onnoeberhard/bachelorprojekt/Screenshot 2020-01-07 at 12.10.59.png

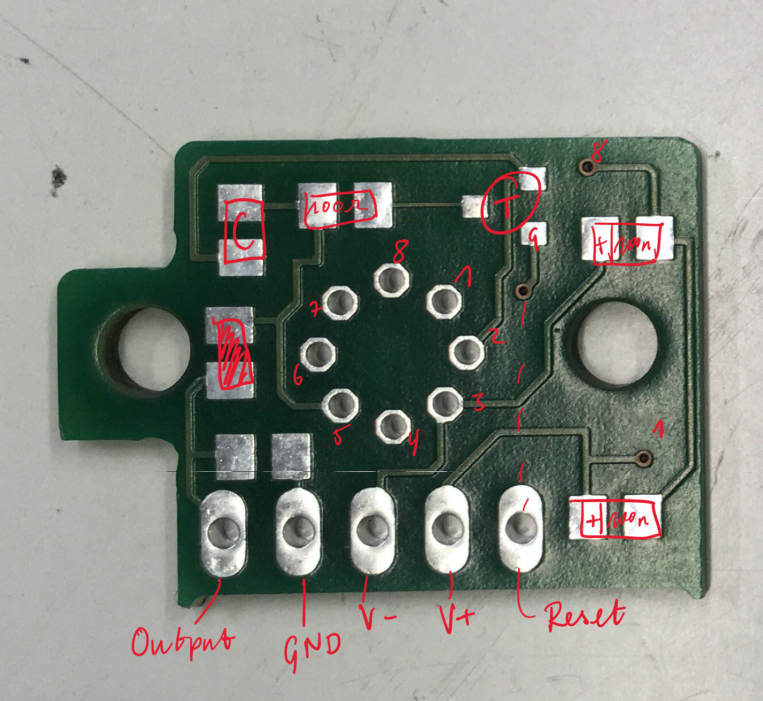
Screenshot 2020-01-07 at 12.10.59.png
