onnoeberhard/bachelorprojekt/Screenshot 2020-01-07 at 12.11.06.png

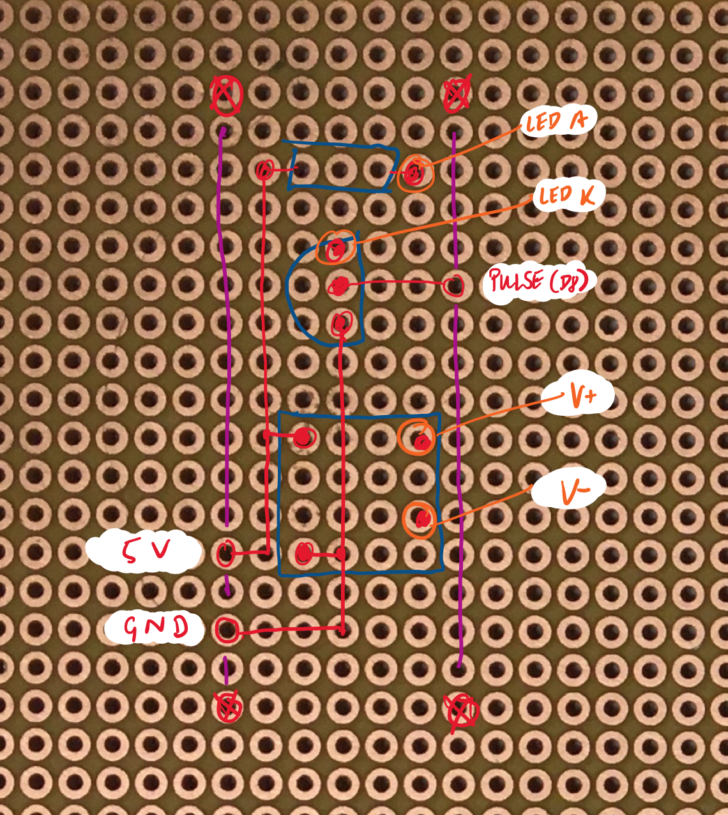
Screenshot 2020-01-07 at 12.11.06.png
