onnoeberhard/bachelorprojekt/Präsentation Onno.pptx

## Elektronik I

## Elektronik II

- Stromversorgung und Steuerung durch Arduino
  - Messwert: “Ouptut”
  - Kondensator entladen: “Reset”
  - LED steuern: “Pulse”
- Zu finden:
  - Widerstand in der LED-Schaltung:
    - Berechnet: R=29,25 Ω
    - Entscheidung: R=33 Ω
  - Integrationszeit: T=100 ms

## Slide 3

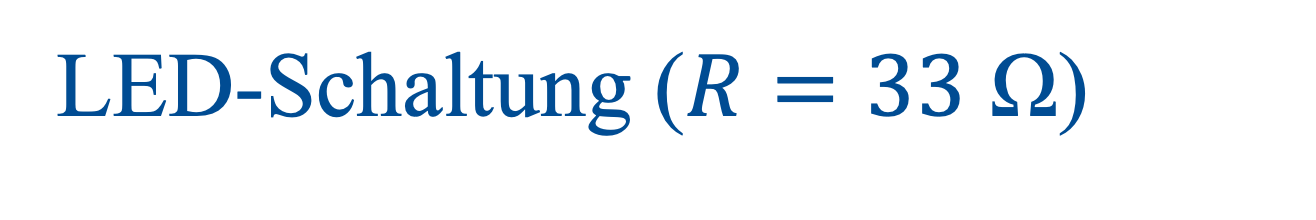
[picture p54: figure]

## Integrationszeit


## Referenzmessung I

- Berechnung der Dämpfung [dB] aus den Messwerten [0..1023]


## Referenzmessung II

- Abziehen des Hintergrundstörwerts

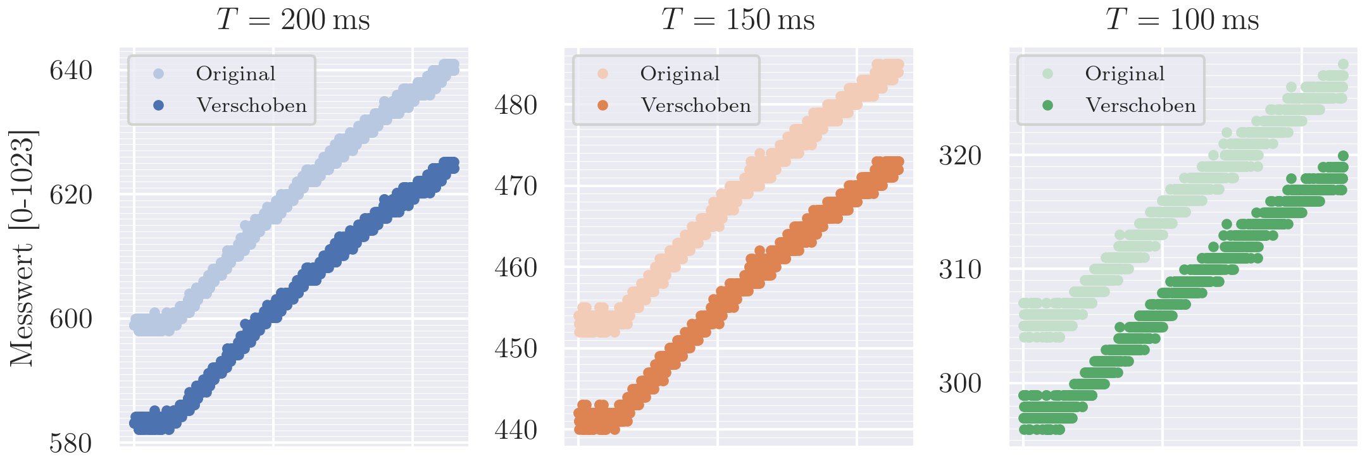
[picture p55: figure]

## Referenzmessung III

- Gättung der Kurve (Gewichteter Mittelwert)


## Referenzmessung IV


## Referenzmessung V

- Umrechnung mit der Formel:
y(t;t_0 , k, b)=kx(t−t_0 )+b
- Gefundene Parameter:
- Für T=100 ms: k=0,073 dB

## Endprodukt

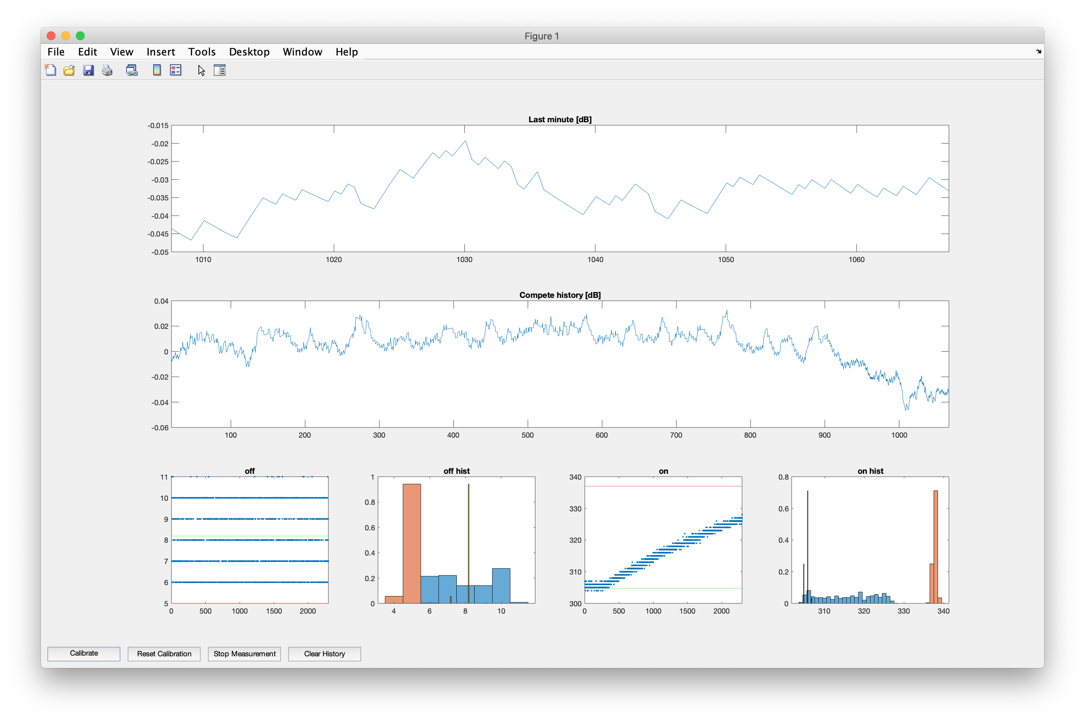
[picture p56: figure]
