onnoeberhard/bachelorprojekt/akf_schaltung.png

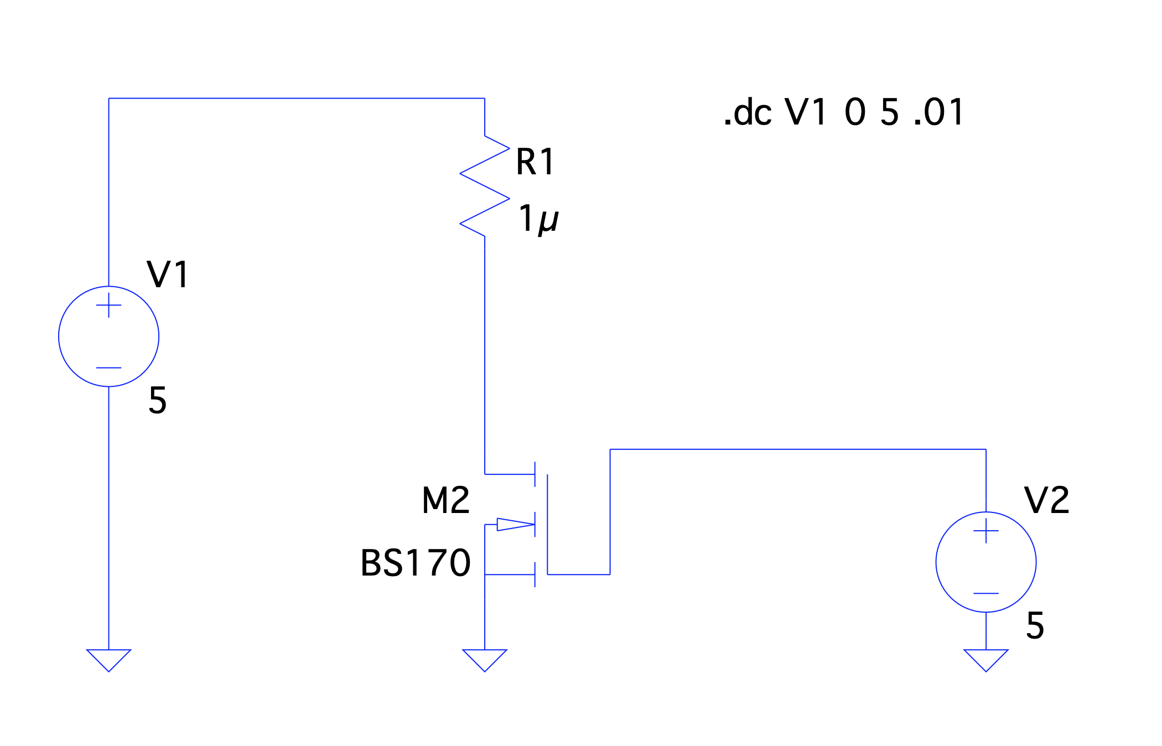
akf_schaltung.png
