onnoeberhard/bachelorprojekt/allspice.png

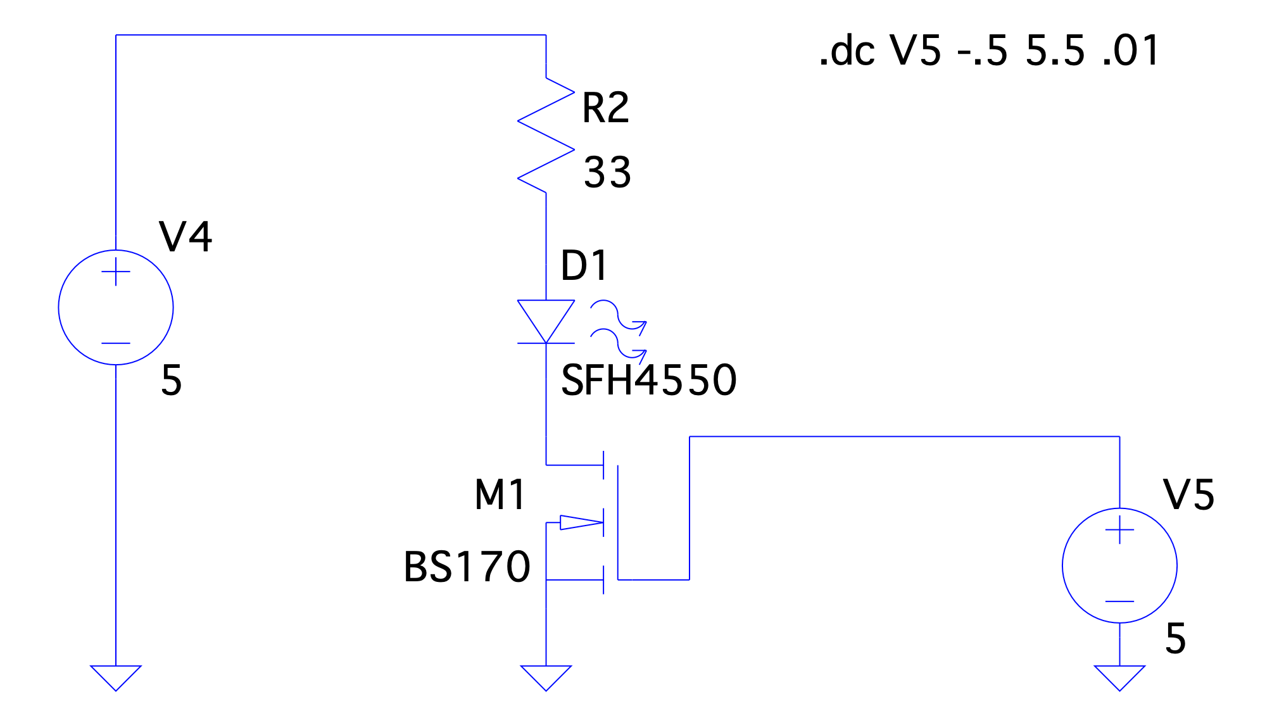
allspice.png
