onnoeberhard/bachelorprojekt/erste Messung.PNG

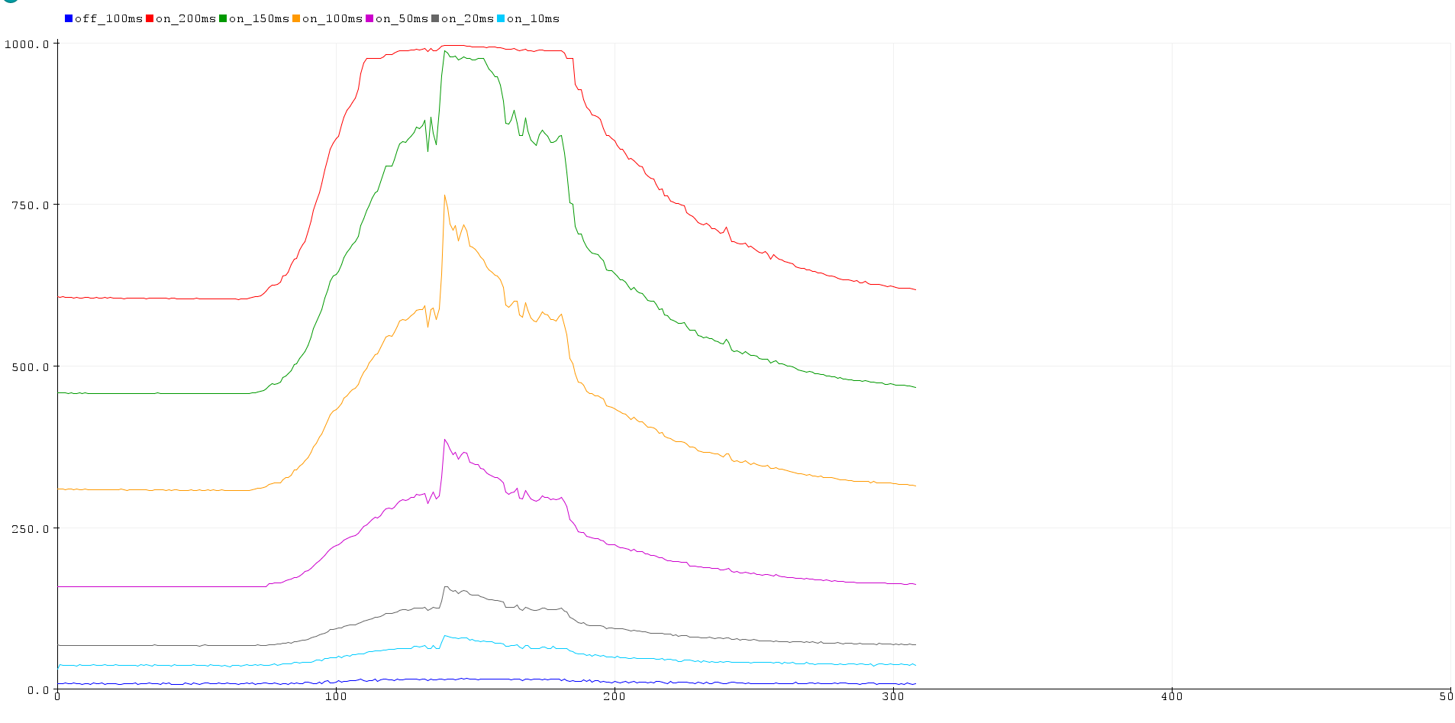
erste Messung.PNG
