onnoeberhard/bachelorprojekt/kalt.png

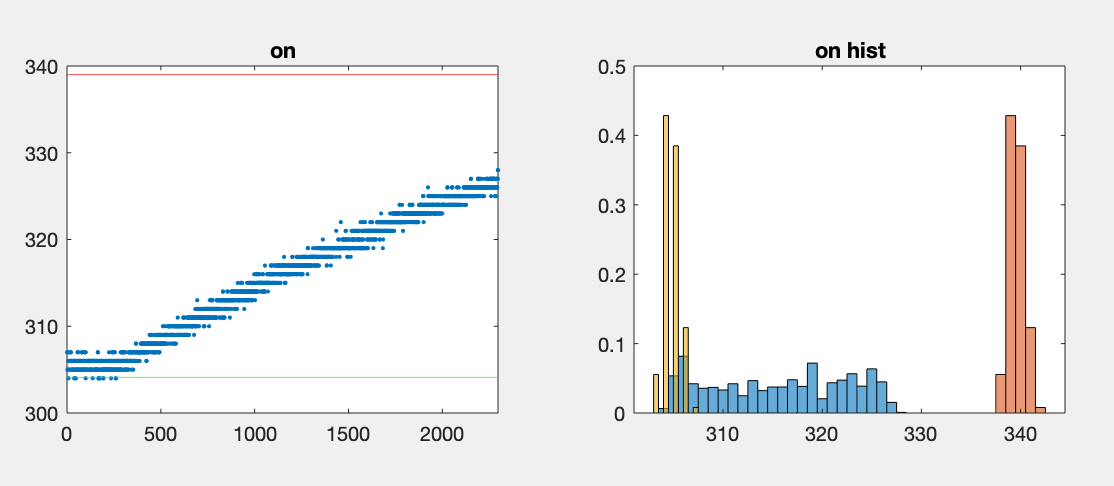
kalt.png
