onnoeberhard/bachelorprojekt/kalt_.png

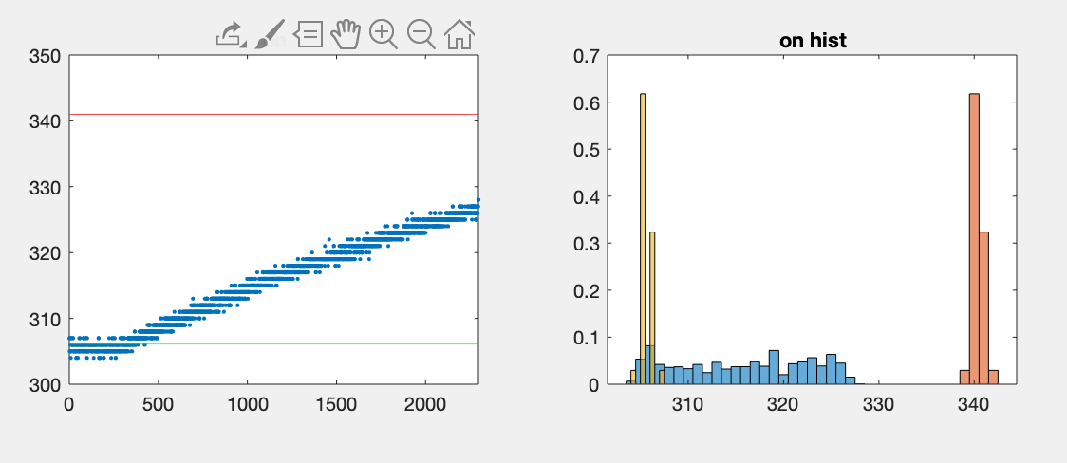
kalt_.png
