onnoeberhard/bachelorprojekt/ledspice.png

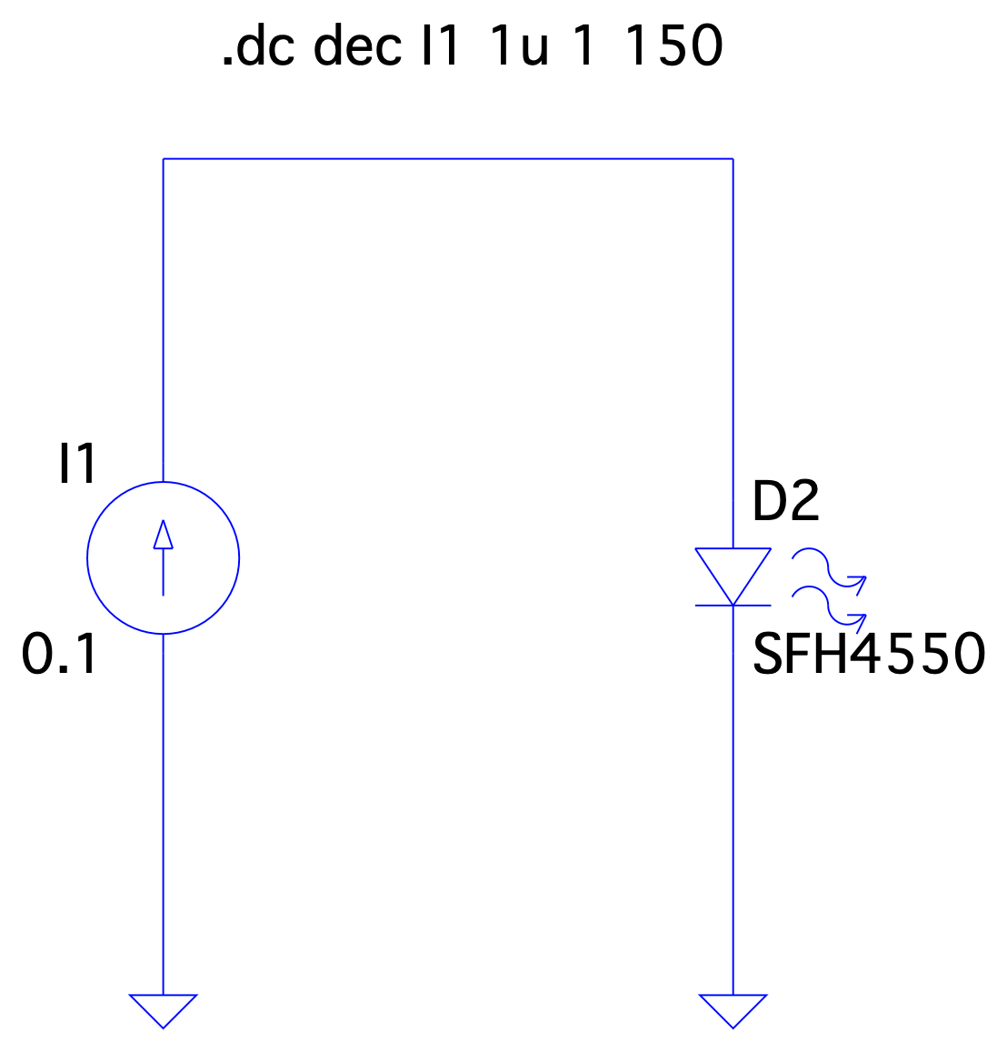
ledspice.png
