onnoeberhard/bachelorprojekt/schaltung.png

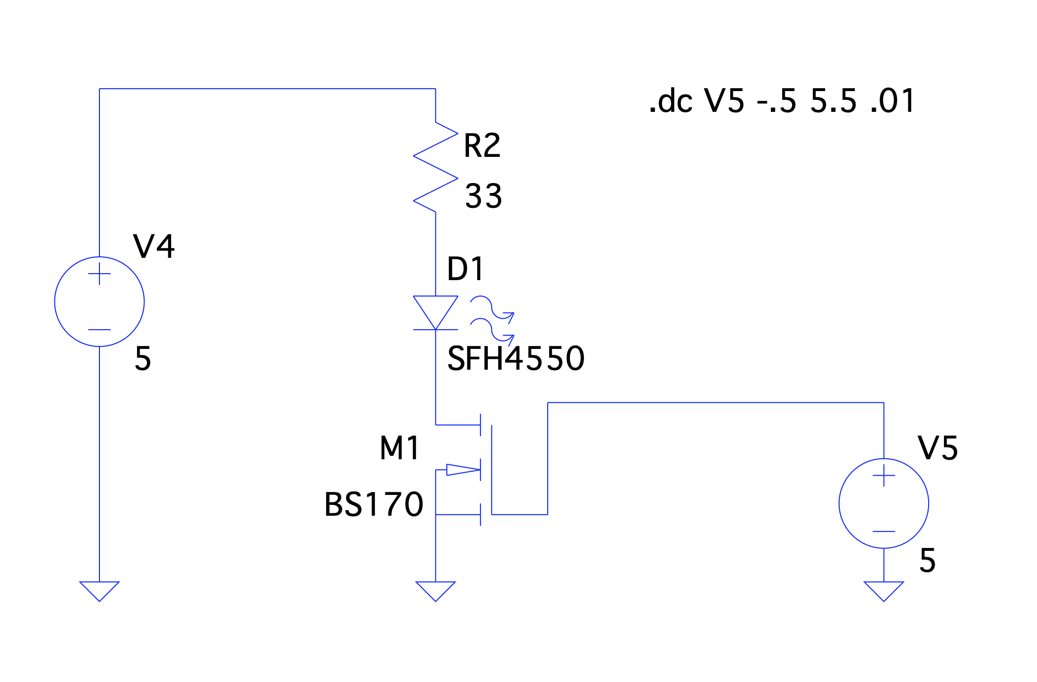
schaltung.png
