onnoeberhard/bachelorprojekt/Screenshot 2019-11-19 at 14.21.47.png

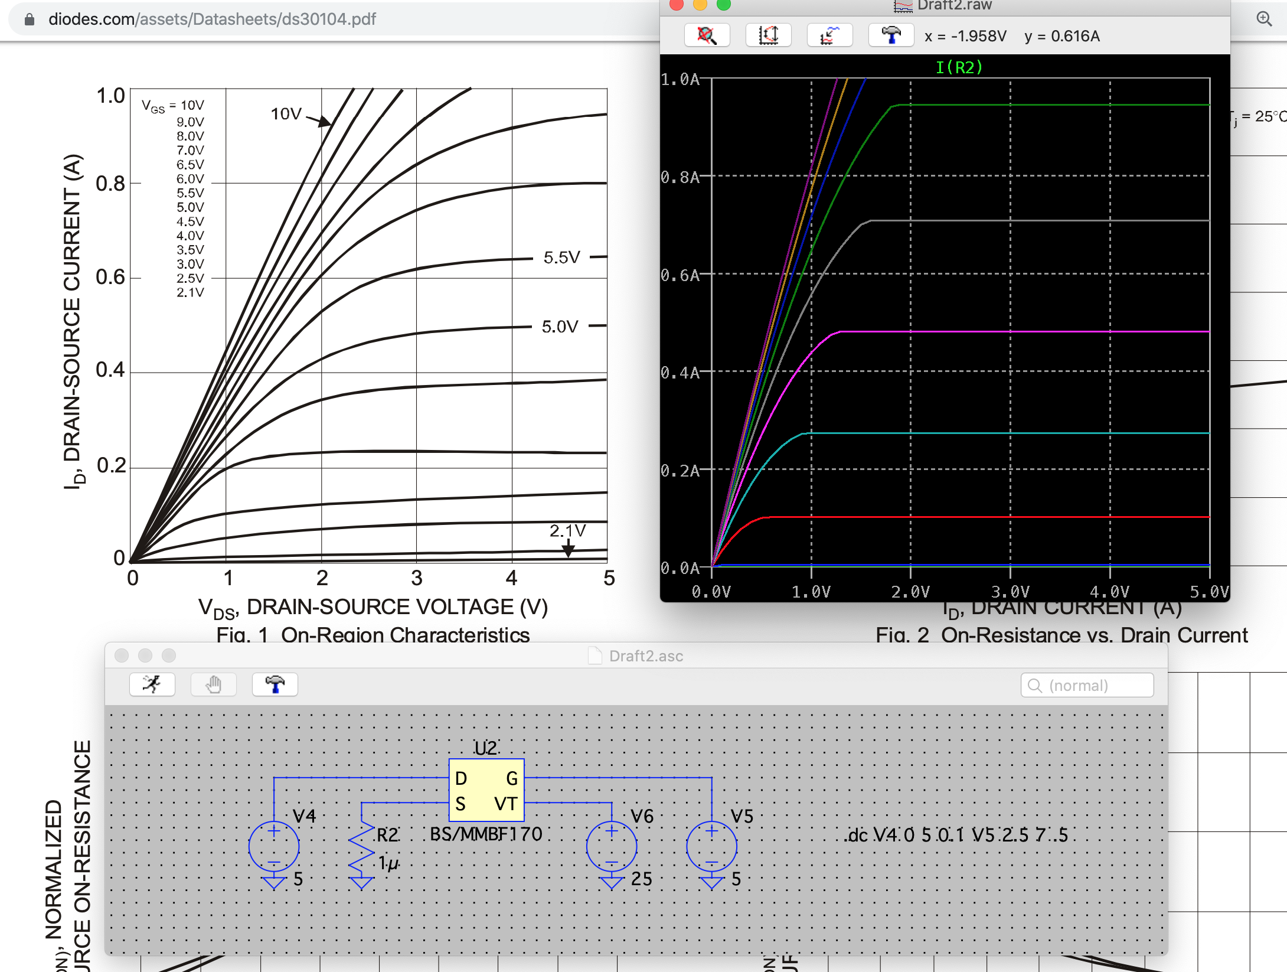
Screenshot 2019-11-19 at 14.21.47.png
