onnoeberhard/bachelorprojekt/Screenshot 2019-11-19 at 14.25.37.png

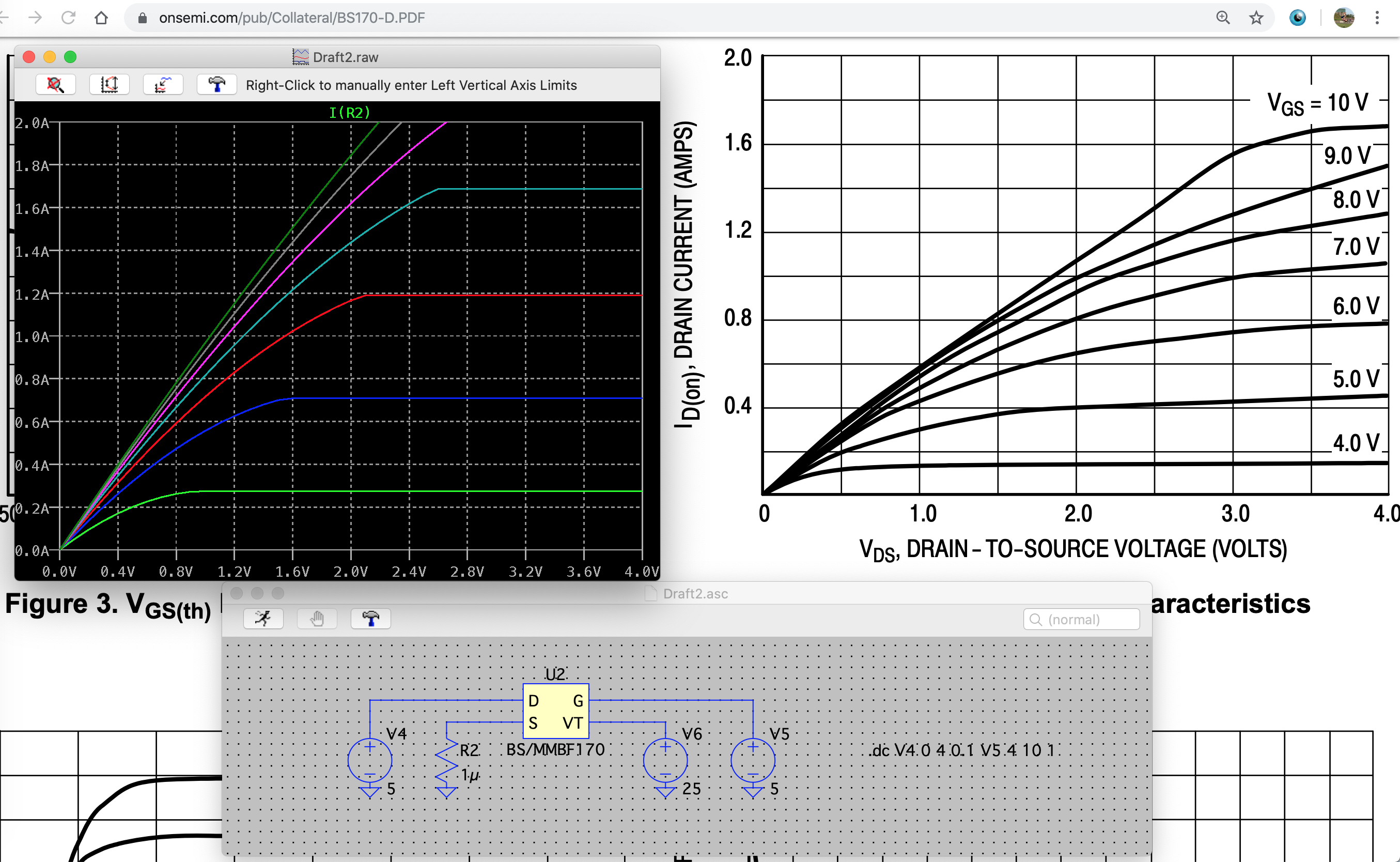
Screenshot 2019-11-19 at 14.25.37.png
