onnoeberhard/bachelorprojekt/Screenshot 2019-11-26 at 10.58.21.png

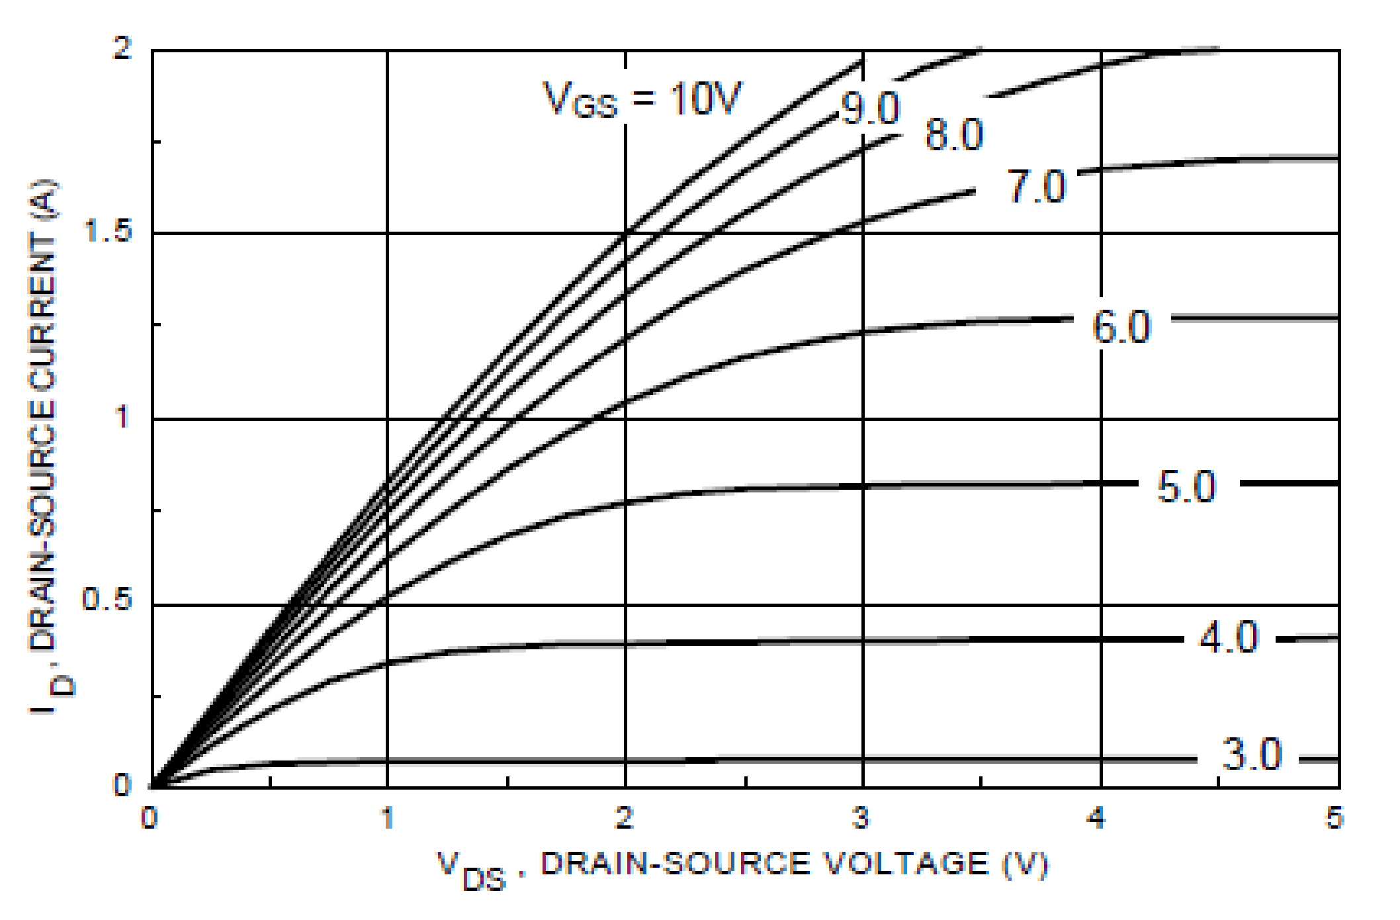
Screenshot 2019-11-26 at 10.58.21.png
