onnoeberhard/bachelorprojekt/Screenshot 2019-11-26 at 14.03.40.png

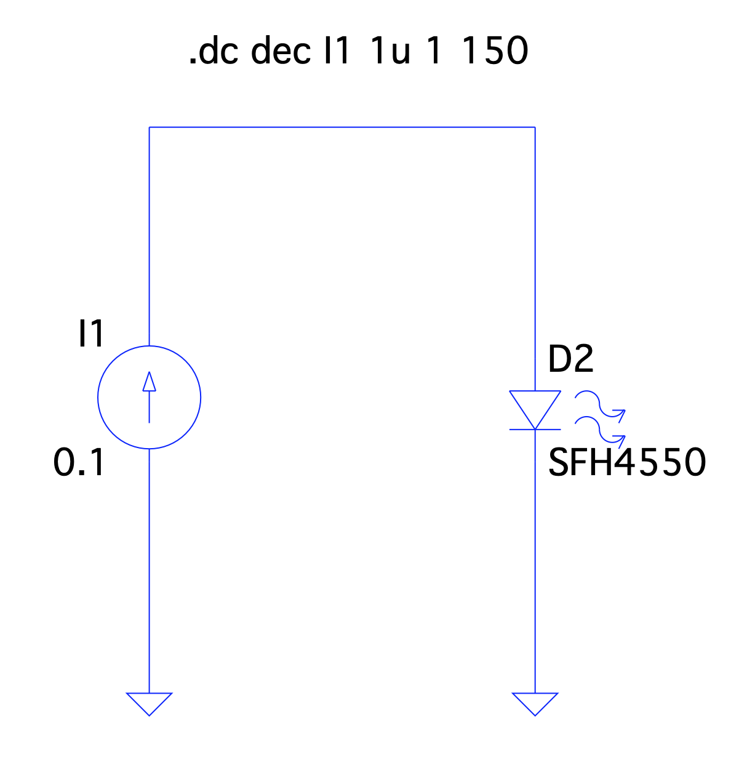
Screenshot 2019-11-26 at 14.03.40.png
