onnoeberhard/bachelorprojekt/Screenshot 2020-03-29 at 17.16.46.png

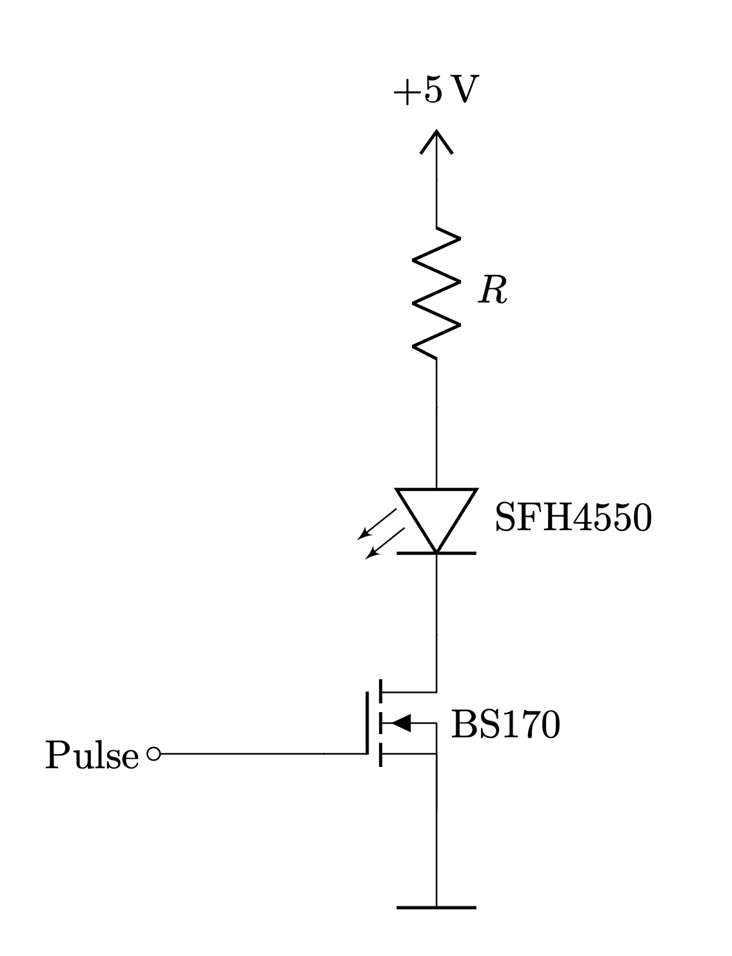
Screenshot 2020-03-29 at 17.16.46.png
