onnoeberhard/bachelorprojekt/Screenshot 2020-03-30 at 19.29.19.png

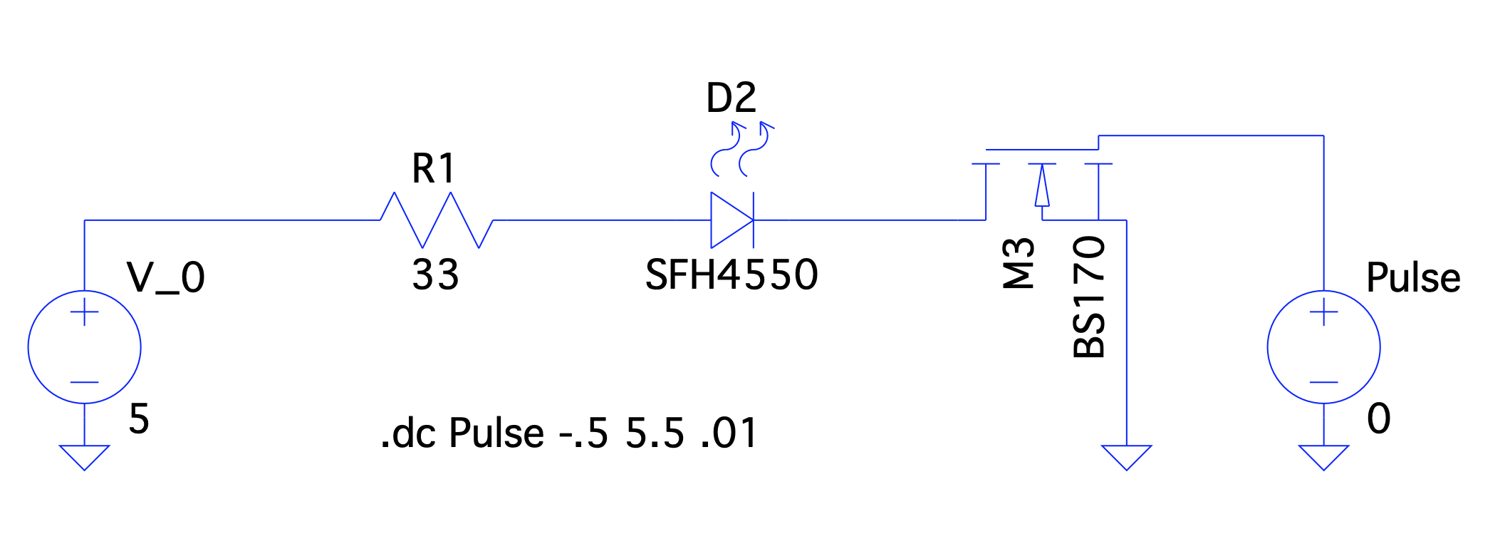
Screenshot 2020-03-30 at 19.29.19.png
