onnoeberhard/bachelorprojekt/Screenshot 2020-04-09 at 15.24.42.png

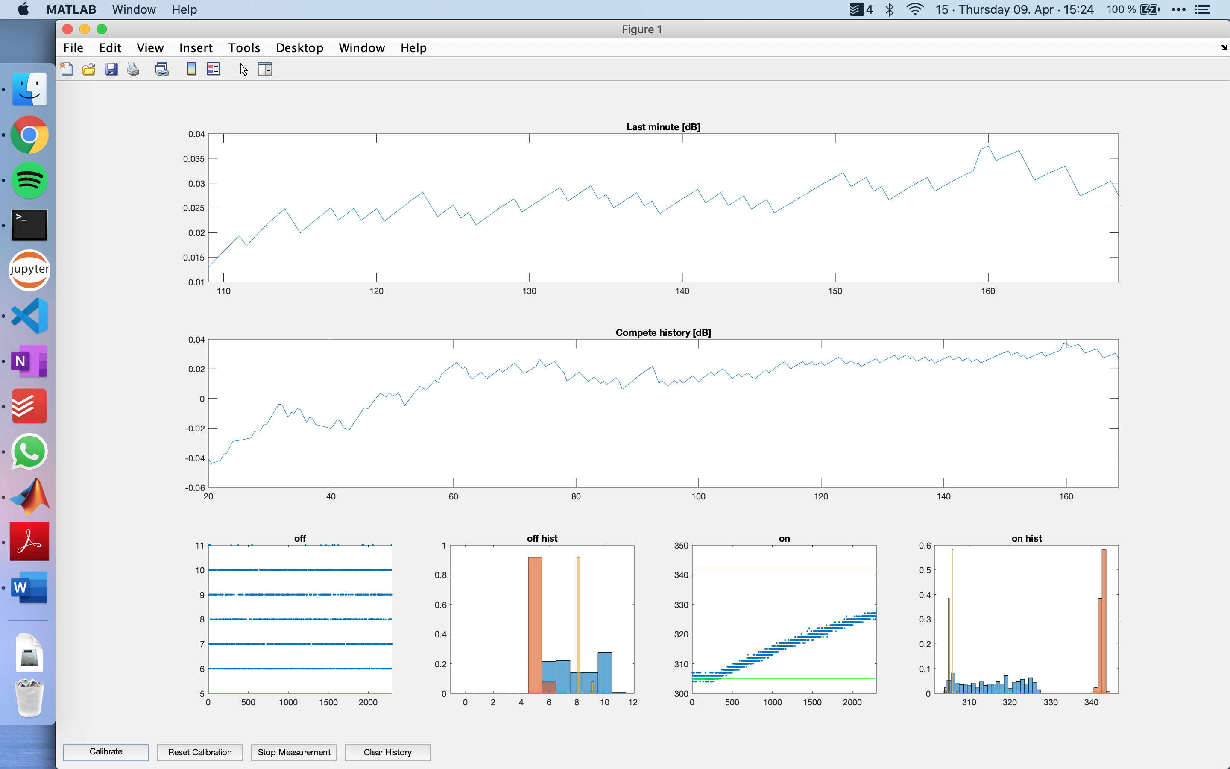
Screenshot 2020-04-09 at 15.24.42.png
