onnoeberhard/bachelorprojekt/Screenshot 2020-04-09 at 15.40.19.png

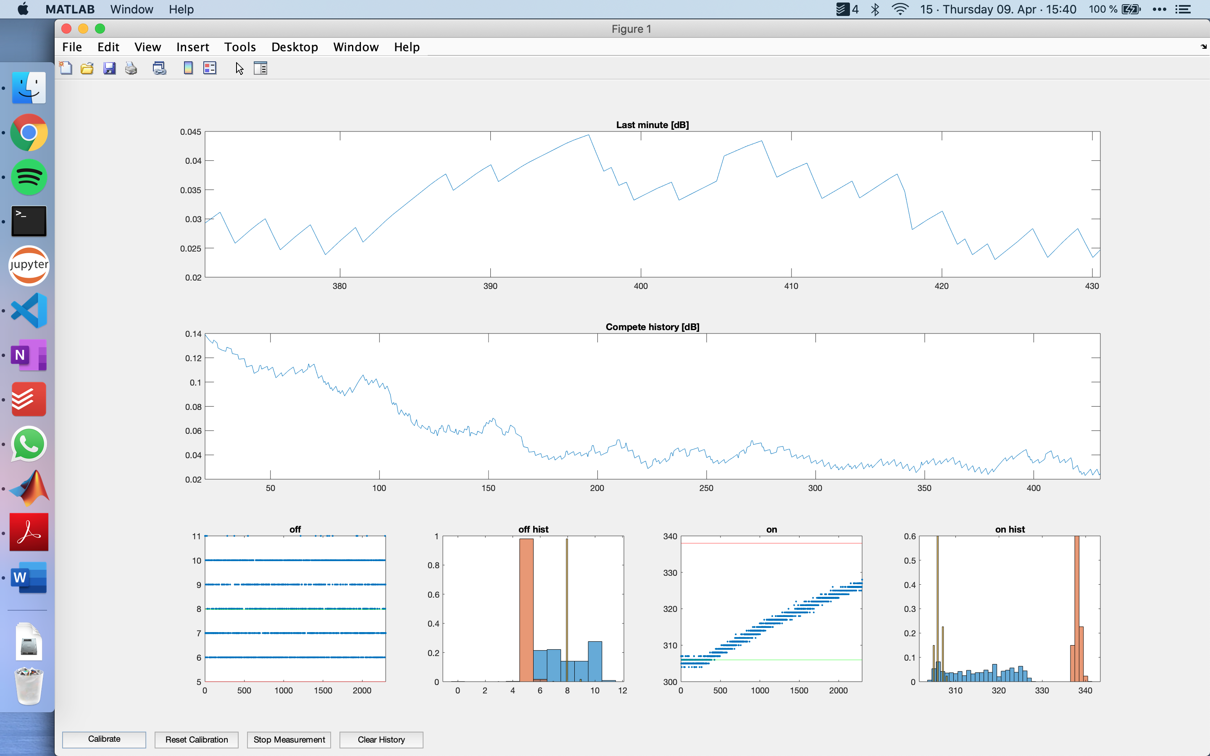
Screenshot 2020-04-09 at 15.40.19.png
