onnoeberhard/bachelorprojekt/Screenshot 2020-04-09 at 15.43.36.png

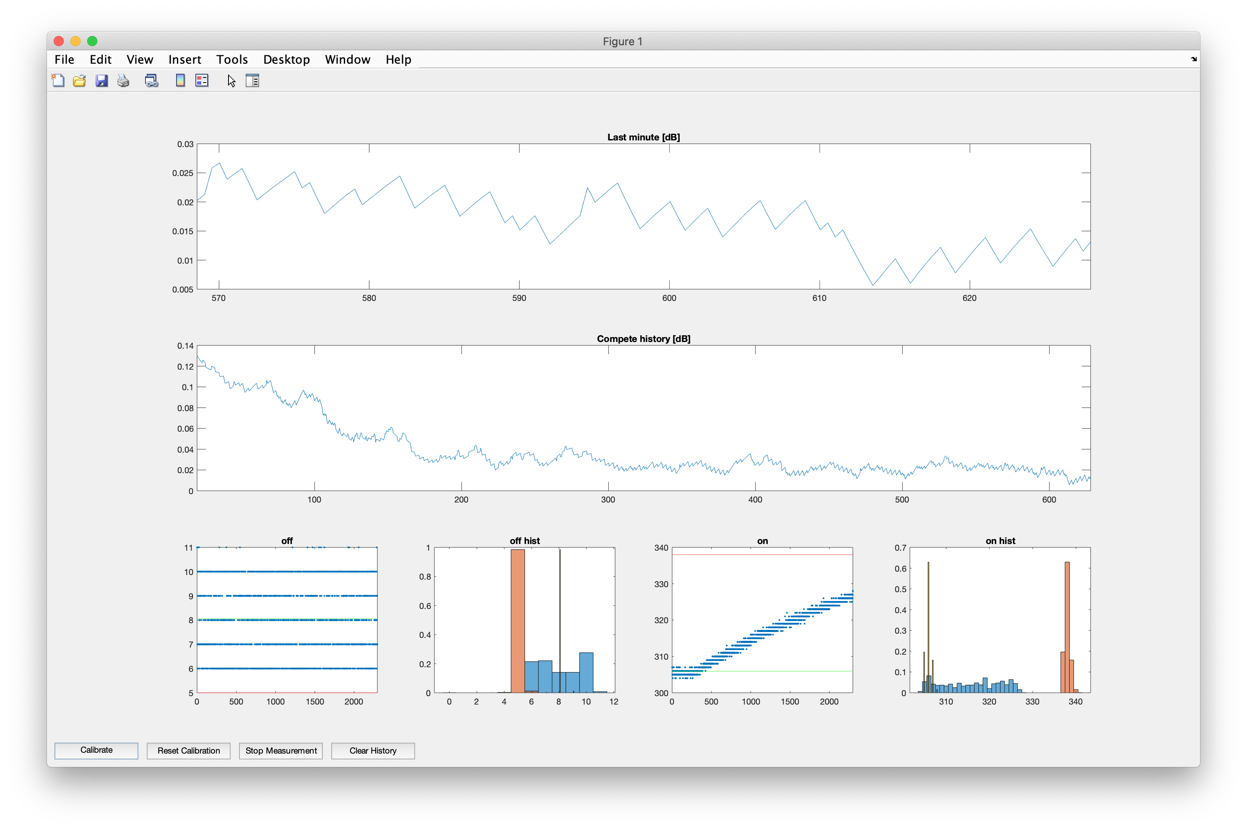
Screenshot 2020-04-09 at 15.43.36.png
