onnoeberhard/bachelorprojekt/transistorspice.png

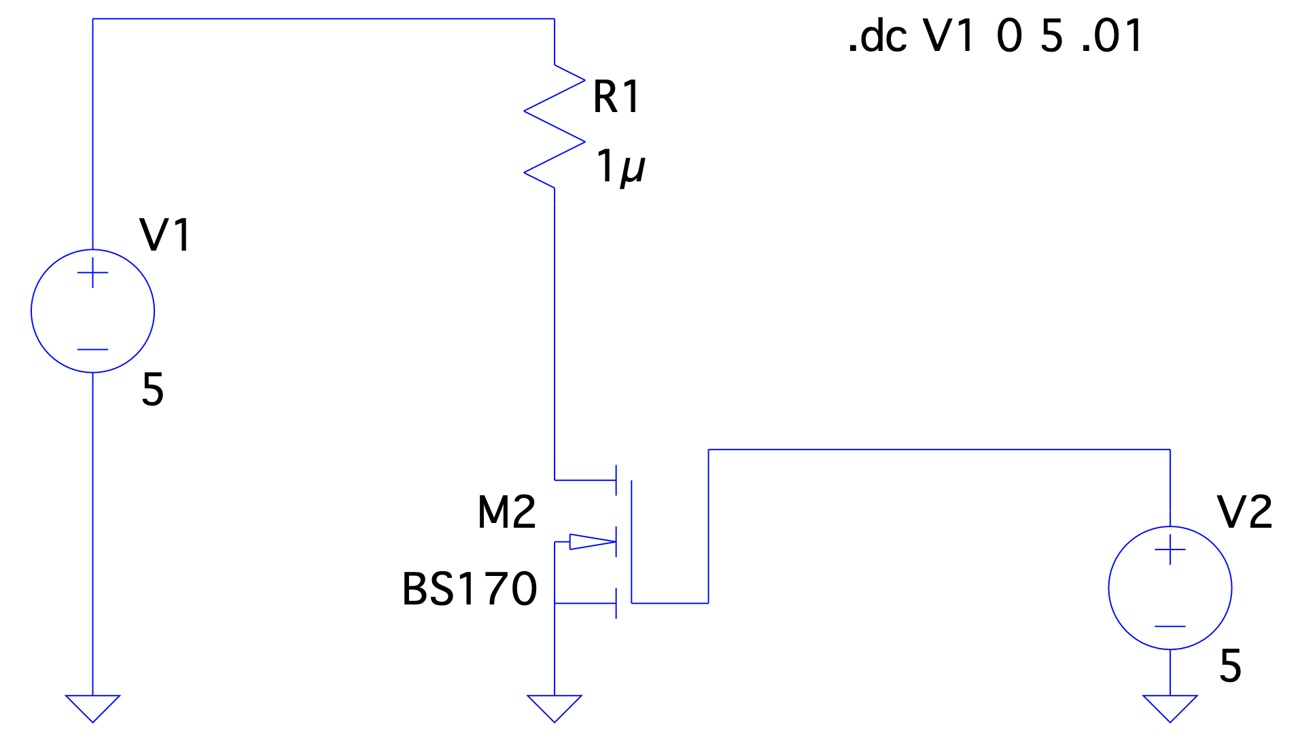
transistorspice.png
