onnoeberhard/bachelorprojekt/warm.png

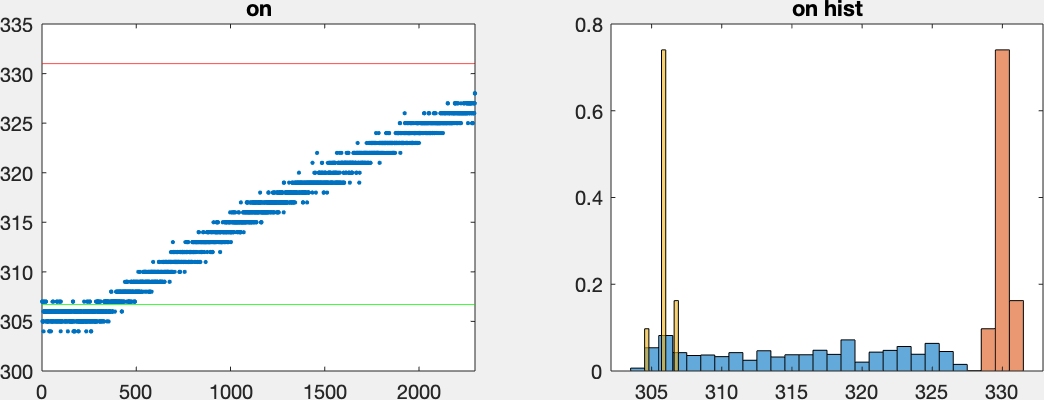
warm.png
