onnoeberhard/bachelorprojekt/warm_.png

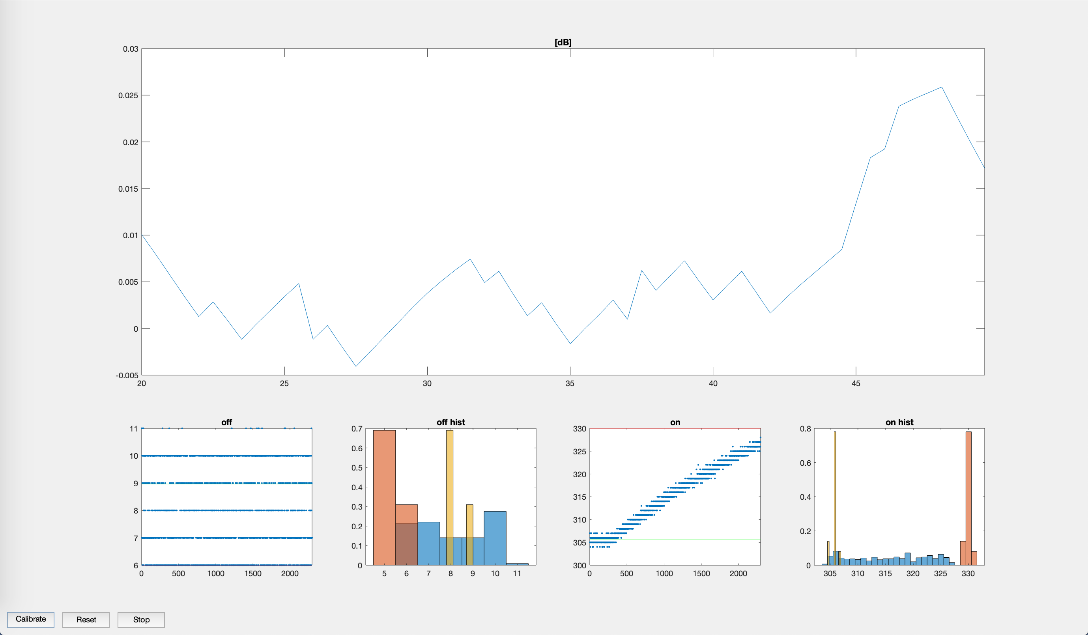
warm_.png
