onnoeberhard/bachelorprojekt/zweite Messung.PNG

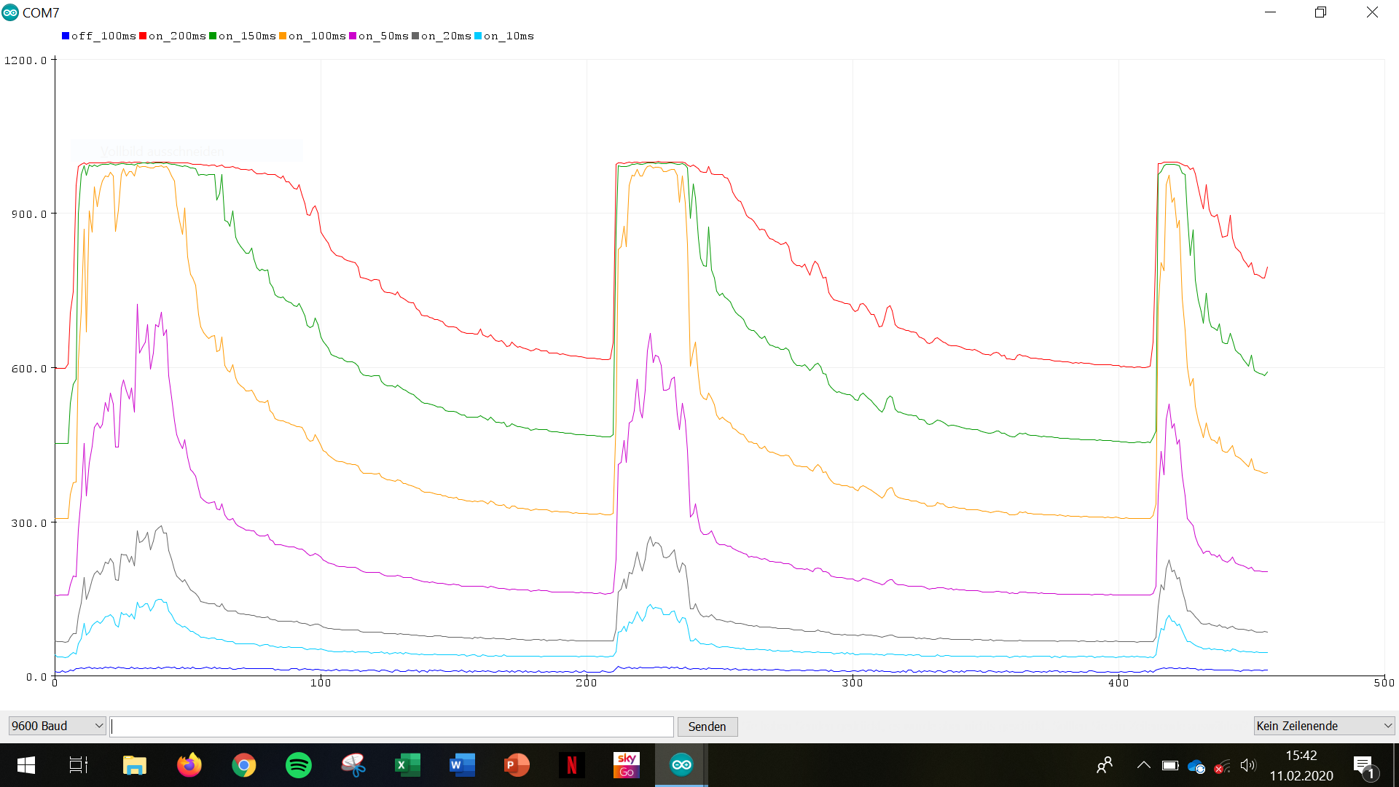
zweite Messung.PNG
