onnoeberhard/bachelorprojekt/operation.txt

pulse	I(D2)
-5.000000000000000e-01	3.435444e-08
-4.900000000000000e-01	3.435444e-08
-4.800000000000000e-01	3.435444e-08
-4.700000000000000e-01	3.435444e-08
-4.600000000000000e-01	3.435444e-08
-4.500000000000000e-01	3.435444e-08
-4.399999999999999e-01	3.435444e-08
-4.299999999999999e-01	3.435444e-08
-4.199999999999999e-01	3.435444e-08
-4.099999999999999e-01	3.435444e-08
-3.999999999999999e-01	3.435444e-08
-3.899999999999999e-01	3.435444e-08
-3.799999999999999e-01	3.435444e-08
-3.699999999999999e-01	3.435444e-08
-3.599999999999999e-01	3.435444e-08
-3.499999999999999e-01	3.435444e-08
-3.399999999999999e-01	3.435444e-08
-3.299999999999998e-01	3.435444e-08
-3.199999999999998e-01	3.435444e-08
-3.099999999999998e-01	3.435444e-08
-2.999999999999998e-01	3.435444e-08
-2.899999999999998e-01	3.435444e-08
-2.799999999999998e-01	3.435444e-08
-2.699999999999998e-01	3.435444e-08
-2.599999999999998e-01	3.435444e-08
-2.499999999999998e-01	3.435444e-08
-2.399999999999998e-01	3.435444e-08
-2.299999999999998e-01	3.435444e-08
-2.199999999999998e-01	3.435444e-08
-2.099999999999997e-01	3.435444e-08
-1.999999999999997e-01	3.435444e-08
-1.899999999999997e-01	3.435444e-08
-1.799999999999997e-01	3.435444e-08
-1.699999999999997e-01	3.435444e-08
-1.599999999999997e-01	3.435444e-08
-1.499999999999997e-01	3.435444e-08
-1.399999999999997e-01	3.435444e-08
-1.299999999999997e-01	3.435444e-08
-1.199999999999997e-01	3.435444e-08
-1.099999999999997e-01	3.435444e-08
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
