onnoeberhard/bachelorprojekt/resistor_problem.png

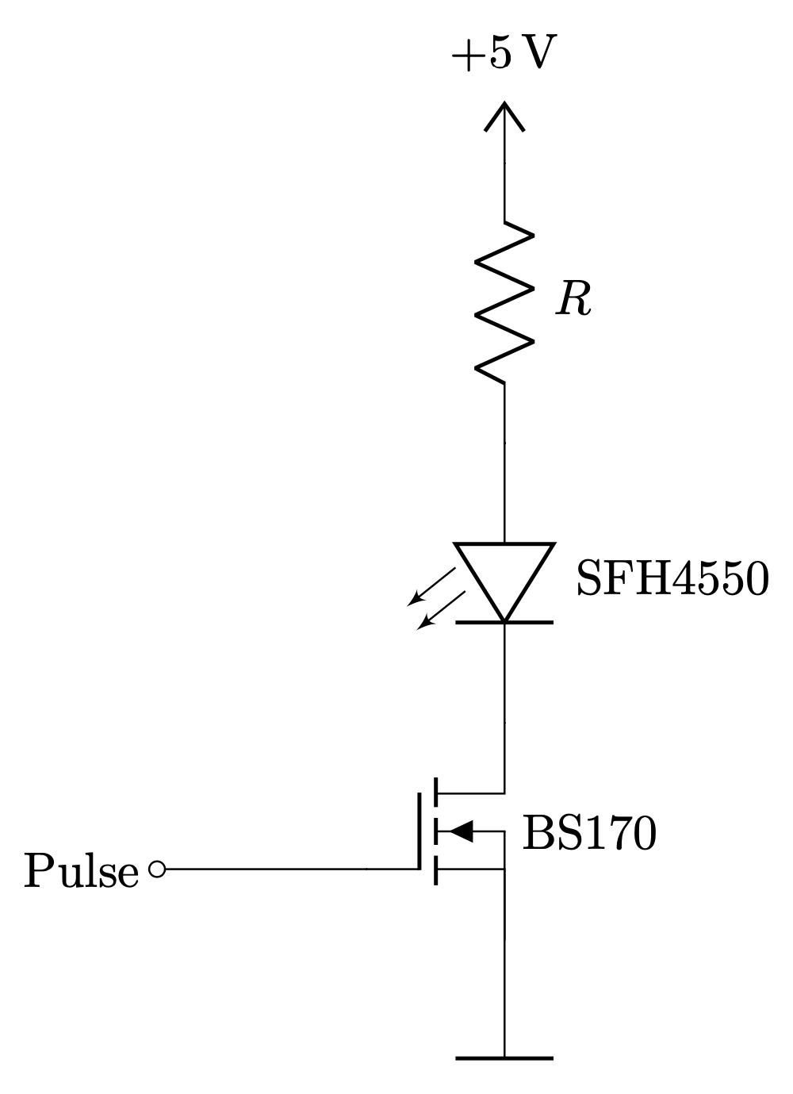
resistor_problem.png
