onnoeberhard/bachelorprojekt/Draft1.asc

C1: cap; 1µF
L1: ind; 1mH
R1: res; 1kOhm
V1: voltage; ""; AC 1
Named nets: 0
.ac dec 1K 1 1G
